pietdevaere/Dumbledore/README.md

Dumbledore
==========

Arduino based system for residential light controll

For more info: see http://devae.re/projects/dumbledore

This project was formerly known as firefly
