pietdevaere/Dumbledore/hardware/firefly.png

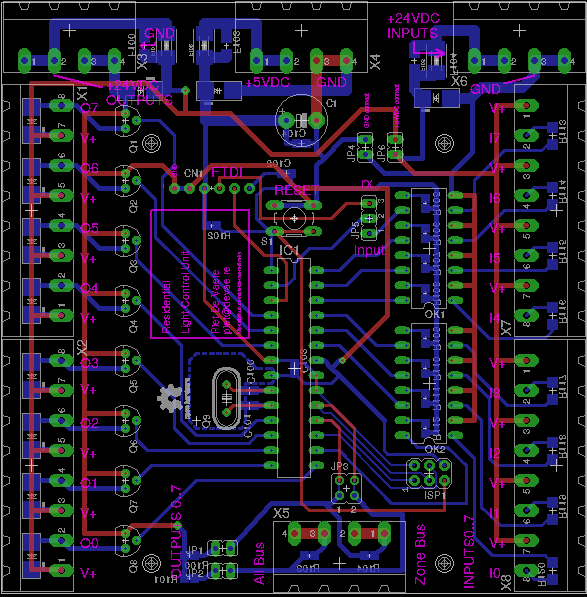
hardware/firefly.png
