pietdevaere/Dumbledore/hardware/sch1.png

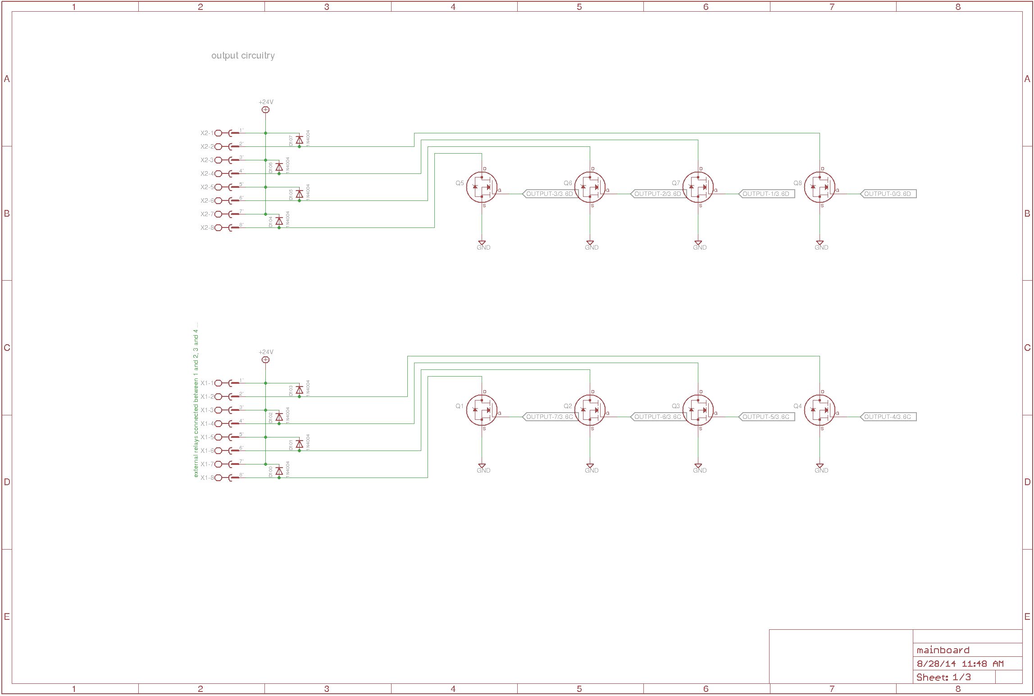
hardware/sch1.png
