pietdevaere/Dumbledore/hardware/sch2.png

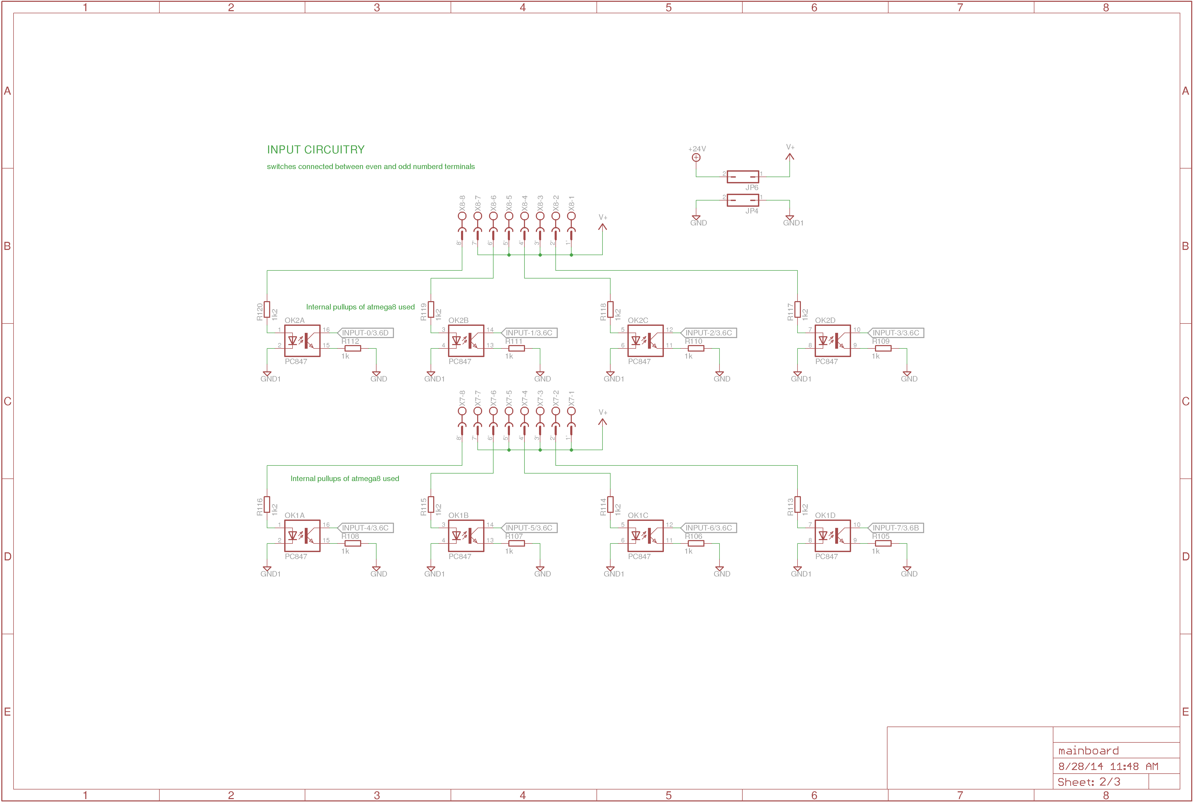
hardware/sch2.png
