pietdevaere/Dumbledore/hardware/sch3.png

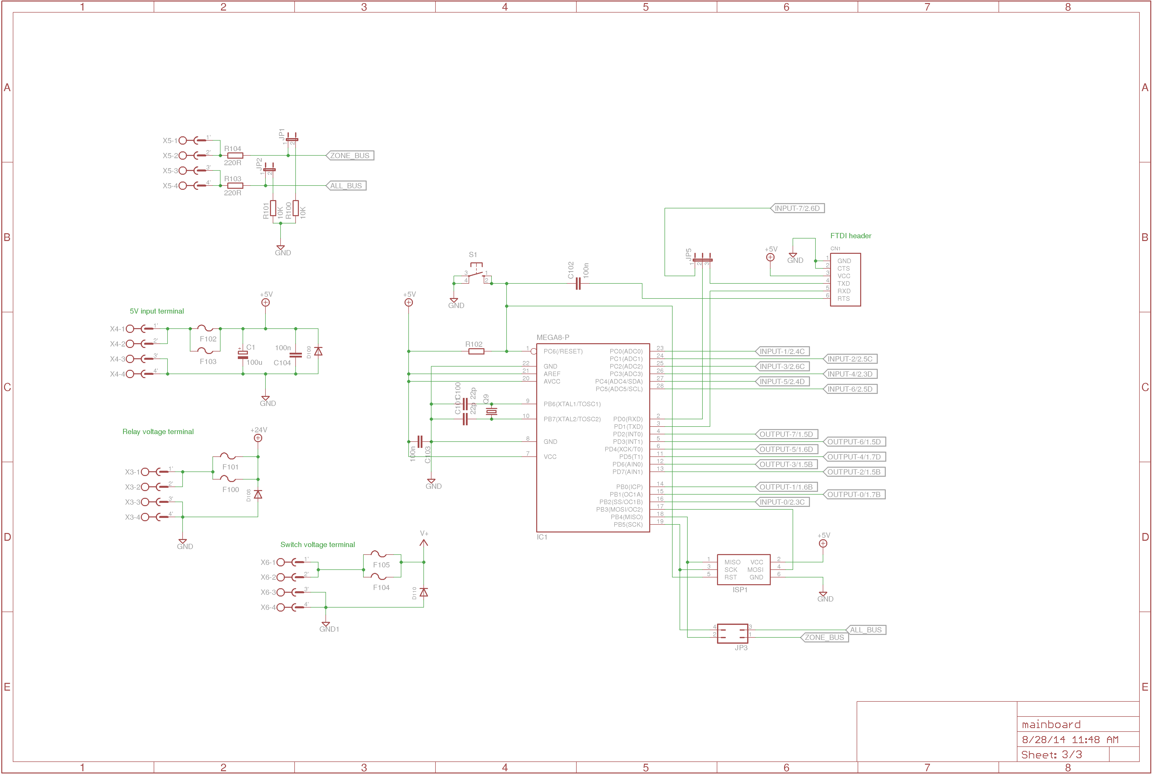
hardware/sch3.png
