pietdevaere/Dumbledore/(commit log)

2014-07-16 state with non faling edge off switching localy
2014-08-05 added the hardware files
    [mainboard.brd, mainboard.sch]
2014-08-05 redid ground for tors
    [mainboard.brd, mainboard.sch]
2014-08-05 added current liminting resistors on the inputs
    [mainboard.brd, mainboard.sch]
2014-08-06 RC1 of the board
    [mainboard.brd, mainboard.sch]
2014-08-06 added some labels, moved mosfets away from the connector to make place for silkskreen
    [mainboard.brd]
2014-08-26 hardware changed, and renamed to dumbledore
    [mainboard.GBL, mainboard.GBO, mainboard.GBP, mainboard.GBS, mainboard.GTL, mainboard.GTO, mainboard.GTP, mainboard.GTS]
2014-08-28 added values for bus resistors
    [mainboard.brd, mainboard.sch]
2014-08-28 Fixed issue with bus, added in correct pin numers
    I added in the actual pins the in and outputs are connected to
    Also fixed an issue where the code would see the fact that it placed
    one of the bus pins high as a sign of an external trigger.
    Fixed this by adding a variable to keep track of the state of the bus
    and only reading out the bus when it is in input mode
    [dumbledore.ino]
2020-08-15 changed mode
    [mainboard.GBL, mainboard.GBO, mainboard.GBP, mainboard.GBS, mainboard.GTL, mainboard.GTO, mainboard.GTP, mainboard.GTS]
2020-08-15 fixed timing logic
    Non void function was returning void, leading to undefined behaviour.
    [dumbledore.ino]
2020-08-15 Fixed pullup issue
    fanpin was written to, but if fanpin is given a random value, that
    could (and did) lead to one of the input pullups being disabled
    [dumbledore.ino]
